msualt/hackclub_week1/README.md

# PCB for hack club week 1: Rocket Flight Controller

Screenshot 2026-10-21 at 1 02 34 PM
For hackclub week 1, i've made a flight controller for a rocket. It handles 4 pyro channels (2 on top, 2 on the bottom). It has an stm32 for the processor, as well as several other sensors such as barometric, altitude, gps, radio, etc. It recieves power from a 2s lipo. Everything was built around breakout boards, so if the rocket experiences any rough landing or the chips just break in general, it should be easy to replace and won't brick the entire board if it does break.

======================================

The stm32 acts as the main computer. I would have used a teensy, but that would have cost way too much. Pins A8, B2, B10, and C15 are hooked up to mosfets, which then link to the pyro channels. Linking them directly would kill the stm32, so the mosfet acts as a mediator. Through headers, the Ms5611 (pressure sensor to measure barometric data at the top of the ascent), GPS module, LoRa module (transmitting data directly down to a computer) and the other sensors are soldered to the headers and are more or less directly linked to the pins on the STM32. Power on the other hand, goes through a p-mosfet, buck regulator (step down), capacitors to smooth out voltage and keep everything safe, as well as a bunch of diodes and resistors. 

BOM
| Item | Qty | Supplier | Cost/item | Total Cost | link |
| :--- | :-- | :--- | :--- | :--- | :--- |
| STM32F411 25M HSE | 1 | WeAct Studio | $4.10 | $4.10 | https://www.aliexpress.us/item/3256801269871873.html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 |
| MS5611 | 1 | UCIPAL | $8.14 | $8.14 | https://www.aliexpress.us/item/3256812474231619.html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 |
| ATGM336H GPS+BDS | 1 | AliExpress | $5.36 | $5.36 | https://www.aliexpress.us/item/3256806218276054.html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 |
| RFM95W 915MHZ | 1 | HOPERF | $4.77 | $4.77 | https://www.aliexpress.us/item/3256803063650327.html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 |
| W25Q128 | 1 | HKHJW Hardware+ | $1.53 | $1.53 | https://www.aliexpress.us/item/3256806686751851.html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 |
| KF301-2P (20pcs) | 1 | Shenzhen DANTEQI | $1.77 | $1.77 | https://www.aliexpress.us/item/3256810430798678.html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 |
| 100PCS AO3401A | 1 | PUMUDDSY | $1.89 | $1.89 | https://www.aliexpress.us/item/2255801091791236.html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 |
| 20PCS TVS Diode | 1 | IBUW | $1.39 | $1.39 | https://www.aliexpress.us/item/3256803765143624.html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 |
| TPS54202DDCR | 1 | MOGAI IC | $2.45 | $2.45 | https://www.aliexpress.us/item/3256809312379547.html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 |
| 10x1x40 Male Headers | 1 | Aliexpress | $0.99 | $0.99 | https://www.aliexpress.us/item/3256807138053957.html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 |
| 0680L5000-01 | 4 | Bel Fuse Inc. | $0.85 | $3.40 | https://www.digikey.com/en/products/detail/bel-fuse-inc/0680L5000-01/10440870 |
| CC0603KRX7R6BB104 | 10  | YAGEO | $0.08 | $0.80 | https://www.digikey.com/en/products/detail/yageo/CC0603KRX7R6BB104/5883741 |
| GRM32DR71C106KA01L | 4 | Murata Electronics | $1.12 | $4.48 | https://www.digikey.com/en/products/detail/murata-electronics/GRM32DR71C106KA01L/586585 |
| C3225X5R1C226M250AA | 10  | TDK | $0.34 | $3.40 | https://www.digikey.com/en/products/detail/tdk/C3225X5R1C226M250AA/569062 |
| CDRH104RNP-101NC | 4 | Sumida America Inc. | $1.39 | $5.56 | https://www.digikey.com/en/products/detail/sumida-america-inc/CDRH104RNP-101NC/956623 |
| UKT1C471MPD1TD | 4 | Nichicon | $0.95 | $3.80 | https://www.digikey.com/en/products/detail/nichicon/UKT1C471MPD1TD/4317259 |
| SS14 Diode | 1 | IGMOPNRQ | $1.82 | $1.82 | https://www.aliexpress.us/item/3256806805197640.html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 |
| IRLZ44N | 1 | Suzpng | $1.59 | $1.59 | https://www.aliexpress.us/item/3256811664475301.html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 |
| USB4215-03-A | 4 | GCT | $0.53 | $2.12 | https://www.digikey.com/en/products/detail/gct/USB4215-03-A/24395489 |
| ADS1115 | 1 | TENSTAR ROBOT | $1.79 | $1.79 | https://www.aliexpress.com/ssr/300000512/BundleDeals2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 |
| SMD Resistors Kit | 1 | FXI Electronics Co., Ltd. Store | $5.39 | $5.39 | https://www.aliexpress.us/item/3256810592729327.html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\*1nceqy1\*_gcl_au\*MTgzMzE2NzMyNy4xNzg4MzczMjU0\*_ga\*NDA1MDIyMTE4LjE3OTIxNTYxMDk.\*_ga_VED1YSGNC7\*czE3OTIxNTYxMDkkbzEkZzEkdDE3OTIxNTcxODgkajE4JGwwJGgw&gatewayAdapt=glo2usa |
| Estimated total shipping | 1 | | | $31.23 | |
