msualt/hackclub_week1/Schematic.sch

## EAGLE design Schematic.sch (2026-11-13)

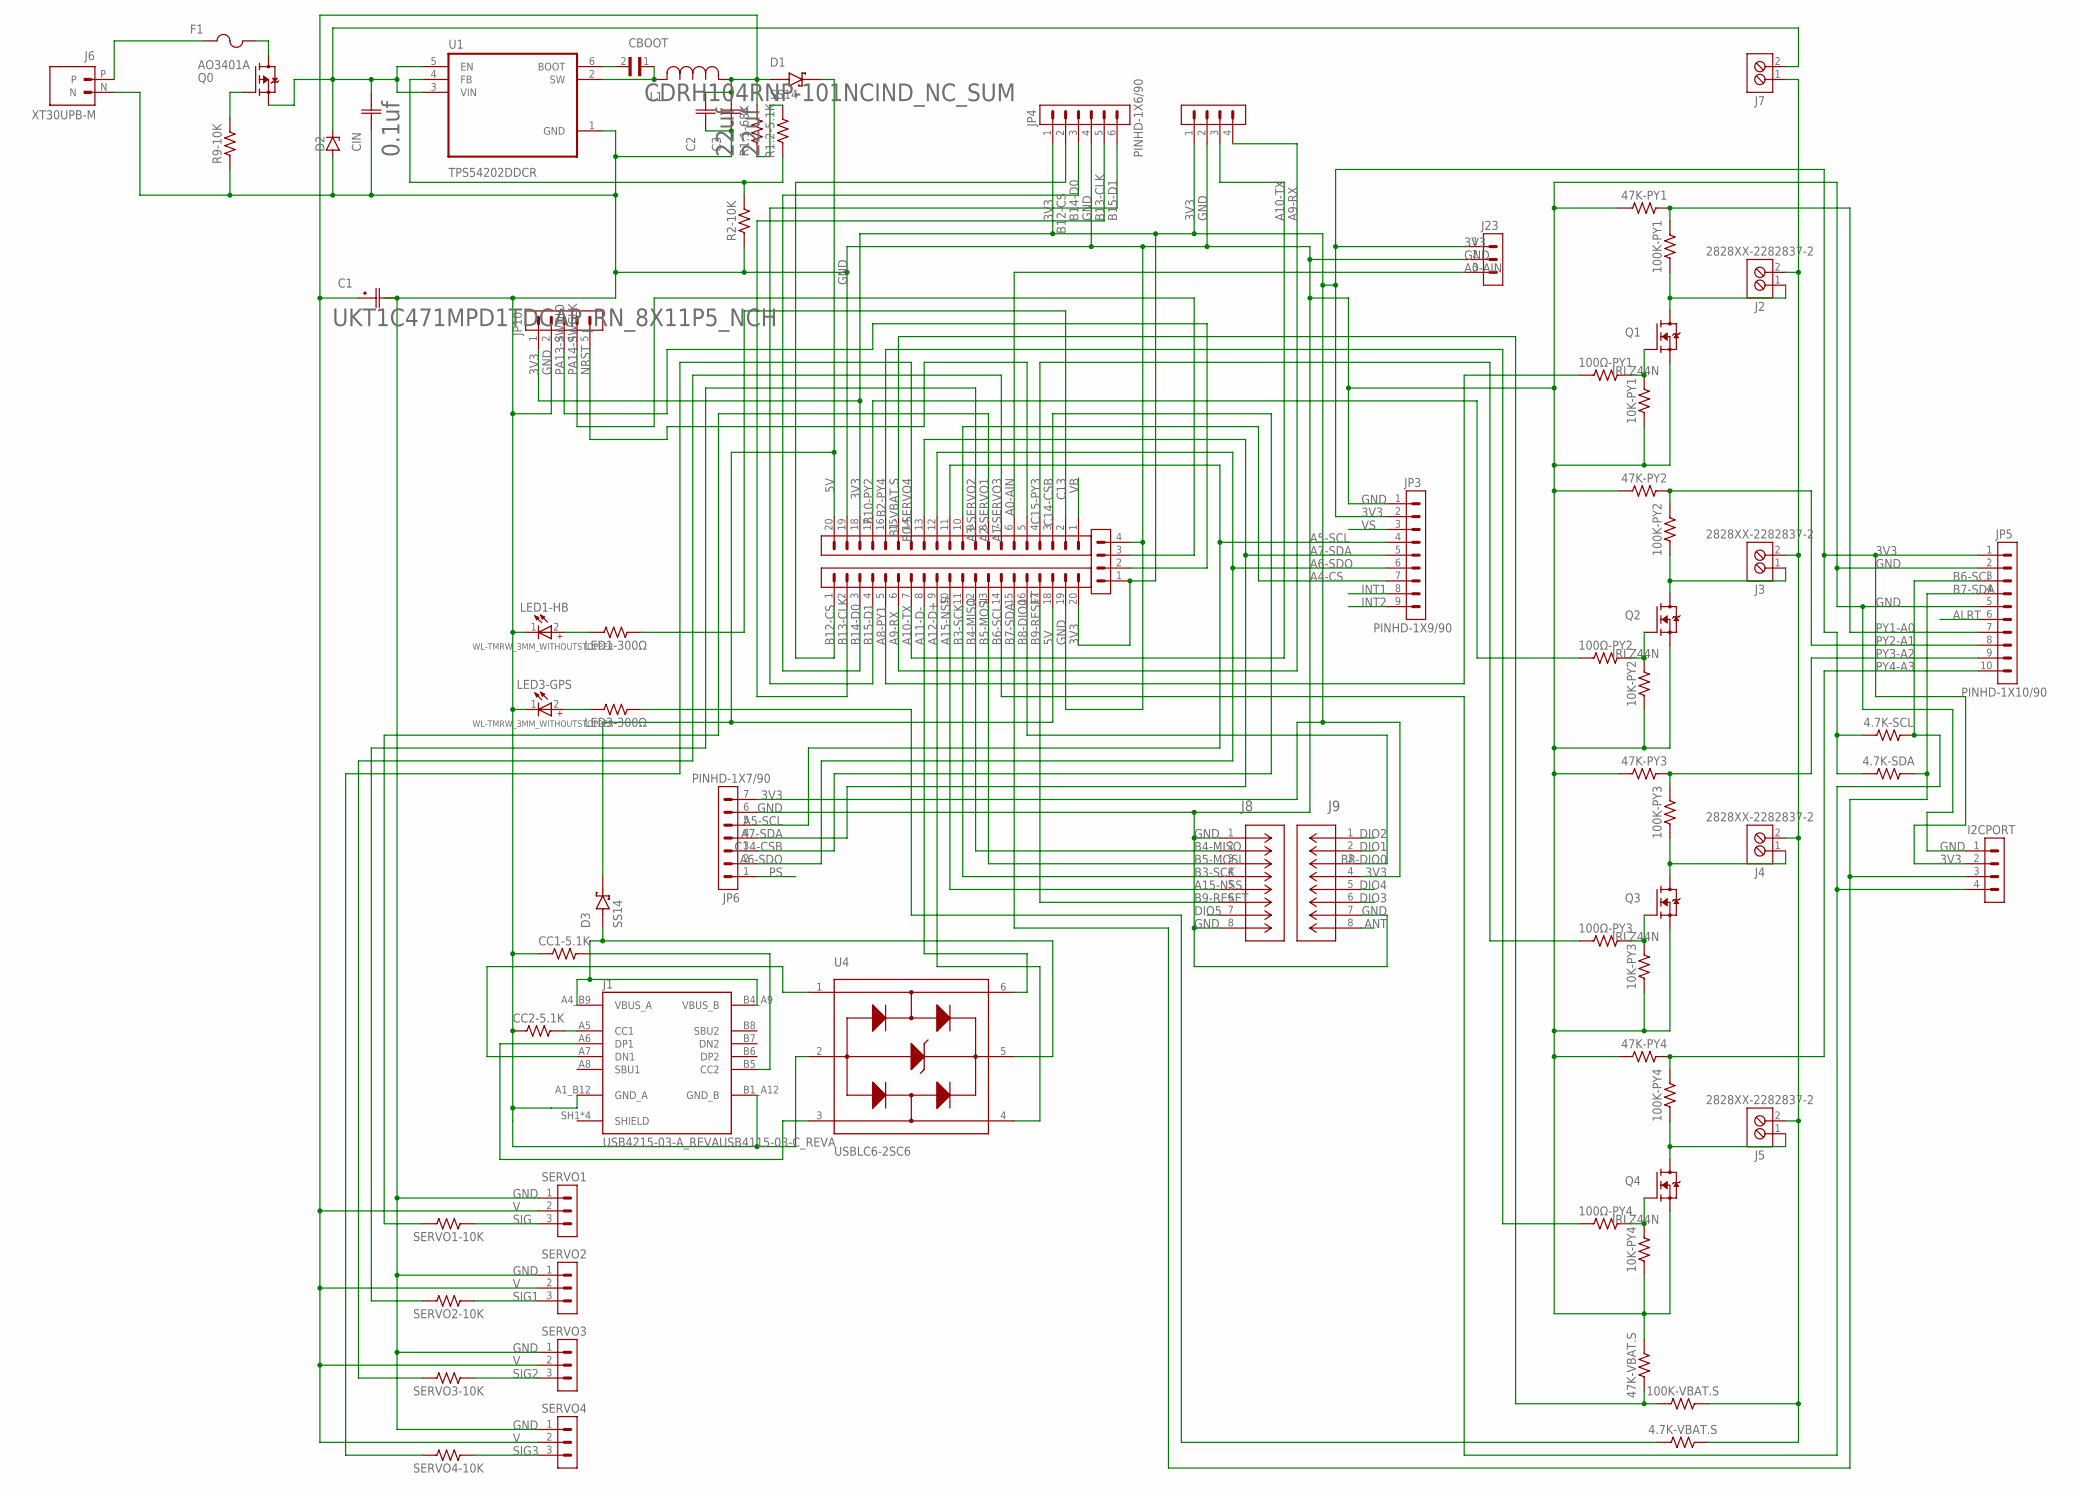
[picture p1: schematic Schematic.sch]

Parts:
4.7K-SCL, 4.7K-SDA, 4.7K-VBAT.S, 10K-PY1, 10K-PY2, 10K-PY3, 10K-PY4, 47K-PY1, 47K-PY2, 47K-PY3, 47K-PY4, 47K-VBAT.S, 100K-PY1, 100K-PY2, 100K-PY3, 100K-PY4, 100K-VBAT.S, 100Ω-PY1, 100Ω-PY2, 100Ω-PY3, 100Ω-PY4: R-US_CHIP-0603(1608-METRIC); RESC1608X60
C1: UKT1C471MPD1TDCAP_RN_8X11P5_NCH; CAP_RN_8X11P5_NCH
C2, C3: 22uf; CAP_C3225-250_TDK
CBOOT: CC0603KRX7R6BB104; CAPC1608X90
CC1-5.1K, CC2-5.1K: R-US_CHIP-0603(1608-METRIC); RESC1608X60
CIN: 0.1uf; CAP_GRM32DC_MUR
D1, D3: SS14; SMA
D2: ZENERDO-214AA(SMB); DIOM5336X265N
F1: 0452005.MRL0452SERIES_LTF; 0452SERIES_LTF
I2CPORT: PINHD-1X4; 1X04
J1: USB4215-03-A_REVAUSB4115-03-C_REVA; GCT_USB4215-03-A_REVA
J2, J3, J4, J5, J7: 2828XX-2282837-2; TERMBLK_508-2N
J6: XT30UPB-M; AMASS_XT30UPB-M
J8, J9: 2PH1-08-UACONN8_2PH1_620X79_ADM; 1X8_2MM_HEADER_MODEL
J23: PINHD-1X3; 1X03
JP1, JP2: PINHD-1X20; 1X20
JP3: PINHD-1X9/90; 1X09/90
JP4: PINHD-1X6/90; 1X06/90
JP5: PINHD-1X10/90; 1X10/90
JP6: PINHD-1X7/90; 1X07/90
JP7, JP11: PINHD-1X4; 1X04
JP10: PINHD-1X5; 1X05
L1: CDRH104RNP-101NCIND_NC_SUM; IND_NC_SUM
LED1-300Ω, LED3-300Ω: R-US_CHIP-0603(1608-METRIC); RESC1608X60
LED1-HB, LED3-GPS: WL-TMRW_3MM_WITHOUTSTOPPER; WL-TMRW_3MM
Q0: AO3401A; SOT23-3
Q1, Q2, Q3, Q4: IRLZ44N; TO254P1054X469X1930-3
R1.1-68K, R1.2-5.1K, R2-10K, R9-10K: R-US_CHIP-0603(1608-METRIC); RESC1608X60
SERVO1, SERVO2, SERVO3, SERVO4: PINHD-1X3; 1X03
SERVO1-10K, SERVO2-10K, SERVO3-10K, SERVO4-10K: R-US_CHIP-0603(1608-METRIC); RESC1608X60
U1: TPS54202DDCR; SOT95P280X110-6N
U4: USBLC6-2SC6; SOT95P280X145-6N

Connections:
3V3: 4.7K-SCL.1, 4.7K-SDA.1, I2CPORT.2, J9.4, J23.1, JP1.20, JP2.18, JP3.2, JP4.1, JP5.1, JP6.7, JP7.1, JP10.1, JP11.1
5V: D1.P2 (C), D3.P2 (C), JP1.18, JP2.20
A0-AIN: J23.3, JP2.6
A1-SERVO3: JP2.7, SERVO3-10K.2
A2-SERVO1: JP2.8, SERVO1-10K.2
A3-SERVO2: JP2.9, SERVO2-10K.2
A4-CS: JP2.10, JP3.7
A5-SCL: JP2.11, JP3.4, JP6.5
A6-SDO: JP2.12, JP3.6, JP6.2
A7-SDA: JP2.13, JP3.5, JP6.4
A8-PY1: 100Ω-PY1.2, JP1.5
A9-RX: JP1.6, JP7.4
A10-TX: JP1.7, JP7.3
A11-D-: JP1.8, U4.6 (I/O1_OUT)
A12-D+: JP1.9, U4.4 (I/O2_OUT)
A15-NSS: J8.5, JP1.10
ALRT: JP5.6
ANT: J9.8
B0-SERVO4: JP2.14, SERVO4-10K.2
B1-VBAT.S: 47K-VBAT.S.1, 100K-VBAT.S.1, JP2.15
B2-PY4: 100Ω-PY4.2, JP2.16
B3-SCK: J8.4, JP1.11
B4-MISO: J8.2, JP1.12
B5-MOSI: J8.3, JP1.13
B6-SCL: 4.7K-SCL.2, I2CPORT.4, JP1.14, JP5.3
B7-SDA: 4.7K-SDA.2, I2CPORT.3, JP1.15, JP5.4
B8-DIO0: J9.3, JP1.16
B9-RESET: J8.6, JP1.17
B10-PY2: 100Ω-PY2.2, JP2.17
B12-CS: JP1.1, JP4.2
B13-CLK: JP1.2, JP4.5
B14-D0: JP1.3, JP4.3
B15-D1: JP1.4, JP4.6
C13: JP2.2, LED1-300Ω.1
C14-CSB: JP2.3, JP6.3
C15-PY3: 100Ω-PY3.2, JP2.4
DIO1: J9.2
DIO2: J9.1
DIO3: J9.6
DIO4: J9.5
DIO5: J8.7
GND: 10K-PY1.1, 10K-PY2.1, 10K-PY3.1, 10K-PY4.1, 47K-PY1.1, 47K-PY2.1, 47K-PY3.1, 47K-PY4.1, 47K-VBAT.S.2, C1.2, C2.1, C3.1, CC1-5.1K.2, CC2-5.1K.2, CIN.1, D2.2 (A), I2CPORT.1, J1.A1_B12 (GND_A), J1.B1_A12 (GND_B), J6.N, J8.1, J8.8, J9.7, J23.2, JP1.19, JP2.19, JP3.1, JP4.4, JP5.2, JP5.5, JP6.6, JP7.2, JP10.2, JP11.4, LED1-HB.1 (-), LED3-GPS.1 (-), Q1.3 (S), Q2.3 (S), Q3.3 (S), Q4.3 (S), R2-10K.1, R9-10K.1, SERVO1.1, SERVO2.1, SERVO3.1, SERVO4.1, U1.1 (GND), U4.2 (GND)
INT1: JP3.8
INT2: JP3.9
unnamed: LED1-300Ω.2, LED1-HB.2 (+)
unnamed: Q0.1 (G), R9-10K.2
unnamed: 10K-PY1.2, 100Ω-PY1.1, Q1.1 (G)
unnamed: 100K-PY1.1, J2.1, Q1.2 (D)
unnamed: 10K-PY2.2, 100Ω-PY2.1, Q2.1 (G)
unnamed: 100K-PY2.1, J3.1, Q2.2 (D)
unnamed: 4.7K-VBAT.S.2, 100K-VBAT.S.2, J2.2, J3.2, J4.2, J5.2, J7.1
unnamed: 10K-PY3.2, 100Ω-PY3.1, Q3.1 (G)
unnamed: 100K-PY3.1, J4.1, Q3.2 (D)
unnamed: LED3-300Ω.2, LED3-GPS.2 (+)
unnamed: CC2-5.1K.1, J1.A5 (CC1)
unnamed: 10K-PY4.2, 100Ω-PY4.1, Q4.1 (G)
unnamed: 100K-PY4.1, J5.1, Q4.2 (D)
unnamed: CC1-5.1K.1, J1.B5 (CC2)
unnamed: J1.A7 (DN1), U4.1 (I/O1_IN)
unnamed: J1.A6 (DP1), U4.3 (I/O2_IN)
unnamed: 4.7K-VBAT.S.1, LED3-300Ω.1
unnamed: CBOOT.2, U1.6 (BOOT)
unnamed: R1.2-5.1K.1, R2-10K.2, U1.4 (FB)
unnamed: CBOOT.1, L1.2, U1.2 (SW)
unnamed: CIN.2, D2.1 (C), J7.2, Q0.2 (S), U1.3 (VIN), U1.5 (EN)
unnamed: R1.1-68K.1, R1.2-5.1K.2
unnamed: F1.2, Q0.3 (D)
unnamed: F1.1, J6.P
unnamed: D3.P1 (A), J1.A4_B9 (VBUS_A), J1.B4_A9 (VBUS_B), U4.5 (VBUS)
NRST: JP2.5, JP10.5
PA13-SWDIO: JP10.3, JP11.2
PA14-SWCLK: JP10.4, JP11.3
PS: JP6.1
PY1-A0: 47K-PY1.2, 100K-PY1.2, JP5.7
PY2-A1: 47K-PY2.2, 100K-PY2.2, JP5.8
PY3-A2: 47K-PY3.2, 100K-PY3.2, JP5.9
PY4-A3: 47K-PY4.2, 100K-PY4.2, JP5.10
SIG: SERVO1.3, SERVO1-10K.1
SIG1: SERVO2.3, SERVO2-10K.1
SIG2: SERVO3.3, SERVO3-10K.1
SIG3: SERVO4.3, SERVO4-10K.1
V: C1.1, C2.2, C3.2, D1.P1 (A), L1.1, R1.1-68K.2, SERVO1.2, SERVO2.2, SERVO3.2, SERVO4.2
VB: JP2.1
VS: JP3.3
