msualt/hackclub_week1/(commit log)

2026-10-21 Update README with new image and remove 'PCB' line
    Removed the line 'PCB' from the README and added a new image.
2026-11-13 Update README with project details and BOM
    Added detailed project description and BOM for the rocket flight controller.
