msualt/hackclub_week1/(notices)

Notices in the files:
parts and their libraries:
0452Series_LTF: COPYRIGHT: Copyright (C) 2026 Ultra Librarian. All rights reserved.
